douggmill/BLE-Arcade-Joystick-LEGO-Arduino/README.md

# BLE-Arcade-Joystick-LEGO-Arduino
# Uses the BleGamepad.h library from https://github.com/lemmingDev/ESP32-BLE-Gamepad by lemmingDev

Shield: [][cc-by]

This work is licensed under a
[Creative Commons Attribution 4.0 International License][cc-by].

[][cc-by]

[cc-by]: http://creativecommons.org/licenses/by/4.0/
[cc-by-image]: https://i.creativecommons.org/l/by/4.0/88x31.png
[cc-by-shield]: https://img.shields.io/badge/License-CC%20BY%204.0-lightgrey.svg
