douggmill/BLE-Arcade-Joystick-LEGO-Arduino/(commit log)

2023-04-22 Added an assembly instruction pdf
2023-04-25 Update to assembly Instruction
2023-05-10 Update LEGO Arduino Arcade Joystick Home Project.pdf
    Added Creative Commons License
