douggmill/BLE-Arcade-Joystick-LEGO-Arduino/(notices)

Notices in the files:
README.md:
CC BY 4.0
